Nixxye/projeto-oficinas1/README.md

# Guitar Healer

## Descrição
Uma das principais dificuldades em um processo de reabilitação motora é a perda de interesse dos pacientes. Os exercícios repetitivos e monótonos que fazem parte desse processo podem ser muito desestimulantes. Este projeto apresenta uma abordagem para superar esse obstáculo: um dispositivo projetado para estimular pacientes que necessitam de reabilitação motora nos dedos.

A ideia principal é transformar o processo de reabilitação em uma espécie de jogo de ritmo inspirado em Guitar Hero, onde o paciente realiza os exercícios necessários para jogar. O dispositivo tem como objetivo tornar o processo de reabilitação mais divertido e interessante, evitando a perda de interesse por parte dos pacientes e, consequentemente, aumentando a eficiência do processo de reabilitação.

## Objetivos
Tornar o processo de reabilitação motora mais envolvente e menos monótono.

Aumentar a motivação dos pacientes durante a reabilitação.

Melhorar a eficiência dos exercícios de reabilitação através da gamificação.

## Funcionalidades
Dispositivo de reabilitação motora com sensores para detectar movimentos dos dedos.

Jogo de ritmo inspirado em Guitar Hero para estimular os exercícios de reabilitação.

Feedback visual e sonoro para manter os pacientes engajados.

## Tecnologias Utilizadas
Linguagens de Programação C/C++ e Python
