Nixxye/projeto-oficinas1/Arduino/README.md

# Arduino

Códigos responsáveis pelo controle do jogo.
