Nixxye/projeto-oficinas1/(list of files, drawings)

Other design files:
Python/py-nrf24-master/doc/nano-nrf24-1.fzz
Python/py-nrf24-master/doc/pizw-nrf24-1-irq.fzz
Python/py-nrf24-master/doc/pizw-nrf24-1.fzz
Python/py-nrf24-master/doc/pizw-nrf24-2.fzz
