Nixxye/projeto-oficinas1/Rasp/lcd.cpp

/*
*
* by Lewis Loflin www.bristolwatch.com lewis@bvu.net
* http://www.bristolwatch.com/rpi/i2clcd.htm
* Using wiringPi by Gordon Henderson
*
*
* Port over lcd_i2c.py to C and added improvements.
* Supports 16x2 and 20x4 screens.
* This was to learn now the I2C lcd displays operate.
* There is no warrenty of any kind use at your own risk.
*
*/
//SDA -> GPIO2
//SLC -> GPIO3
#include <wiringPiI2C.h>
#include <wiringPi.h>
#include <stdlib.h>
#include <stdio.h>
#include <string.h>
// Define some device parameters
#define I2C_ADDR   0x27 // I2C device address

// Define some device constants
#define LCD_CHR  1 // Mode - Sending data
#define LCD_CMD  0 // Mode - Sending command

#define LINE1  0x80 // 1st line
#define LINE2  0xC0 // 2nd line

#define LCD_BACKLIGHT   0x08  // On
// LCD_BACKLIGHT = 0x00  # Off

#define ENABLE  0b00000100 // Enable bit

void lcd_init(void);
void lcd_byte(int bits, int mode);
void lcd_toggle_enable(int bits);

// added by Lewis
void typeInt(int i);
void typeFloat(float myFloat);
void lcdLoc(int line); //move cursor
void ClrLcd(void); // clr LCD return home
void typeln(const char *s);
void typeChar(char val);
int fd;  // seen by all subroutines

void ClrScnd();
void moveText(char *txt, int tam, char *s);
int main()   {

  if (wiringPiSetup () == -1) exit (1);

  fd = wiringPiI2CSetup(I2C_ADDR);

  //printf("fd = %d ", fd);

  lcd_init(); // setup LCD

  char music[] = "Passei quase duas horas no terceiro boss de lies of p D: ";
  char s[] = "                ";
  int size = strlen(music) - 1;
  while (1)   {

    lcdLoc(LINE1);
    typeln("Guitar Healer");
    lcdLoc(LINE2);
    typeln(s);
    moveText(music, size, s);
    delay(200);
    //ClrLcd();
    ClrScnd();
  }

  return 0;

}

void moveText(char *txt, int tam)
{
  char aux = txt[0];
  for (int i = 0; i < tam; i++)
  {
    txt[i] = txt[i+1];
  }
  txt[tam] = aux;
}

// float to string
void typeFloat(float myFloat)   {
  char buffer[20];
  sprintf(buffer, "%4.2f",  myFloat);
  typeln(buffer);
}

// int to string
void typeInt(int i)   {
  char array1[20];
  sprintf(array1, "%d",  i);
  typeln(array1);
}

// clr lcd go home loc 0x80
void ClrLcd(void)   {
  lcd_byte(0x01, LCD_CMD);
  lcd_byte(0x02, LCD_CMD);
}
void ClrScnd(void)   {
  lcdLoc(LINE2);
  typeln("                    ");
  lcdLoc(LINE2);

}
// go to location on LCD
void lcdLoc(int line)   {
  lcd_byte(line, LCD_CMD);
}

// out char to LCD at current position
void typeChar(char val)   {

  lcd_byte(val, LCD_CHR);
}


// this allows use of any size string
void typeln(const char *s)   {

  for (int i = 0; *s && i < 16; i++) lcd_byte(*(s++), LCD_CHR);

}

void lcd_byte(int bits, int mode)   {

  //Send byte to data pins
  // bits = the data
  // mode = 1 for data, 0 for command
  int bits_high;
  int bits_low;
  // uses the two half byte writes to LCD
  bits_high = mode | (bits & 0xF0) | LCD_BACKLIGHT ;
  bits_low = mode | ((bits << 4) & 0xF0) | LCD_BACKLIGHT ;

  // High bits
  wiringPiI2CReadReg8(fd, bits_high);
  lcd_toggle_enable(bits_high);

  // Low bits
  wiringPiI2CReadReg8(fd, bits_low);
  lcd_toggle_enable(bits_low);
}

void lcd_toggle_enable(int bits)   {
  // Toggle enable pin on LCD display
  delayMicroseconds(500);
  wiringPiI2CReadReg8(fd, (bits | ENABLE));
  delayMicroseconds(500);
  wiringPiI2CReadReg8(fd, (bits & ~ENABLE));
  delayMicroseconds(500);
}


void lcd_init()   {
  // Initialise display
  lcd_byte(0x33, LCD_CMD); // Initialise
  lcd_byte(0x32, LCD_CMD); // Initialise
  lcd_byte(0x06, LCD_CMD); // Cursor move direction
  lcd_byte(0x0C, LCD_CMD); // 0x0F On, Blink Off
  lcd_byte(0x28, LCD_CMD); // Data length, number of lines, font size
  lcd_byte(0x01, LCD_CMD); // Clear display
  delayMicroseconds(500);
}
