Nixxye/projeto-oficinas1/Rasp/motor_micro.py

from time import sleep
import pigpio

DIR = 21     # Direction GPIO Pin
STEP = 20    # Step GPIO Pin

# Connect to pigpiod daemon
pi = pigpio.pi()

# Set up pins as an output
pi.set_mode(DIR, pigpio.OUTPUT)
pi.set_mode(STEP, pigpio.OUTPUT)

MODE = (14, 15, 18)   # Microstep Resolution GPIO Pins
RESOLUTION = {'Full': (0, 0, 0),
              'Half': (1, 0, 0),
              '1/4': (0, 1, 0),
              '1/8': (1, 1, 0),
              '1/16': (0, 0, 1),
              '1/32': (1, 0, 1)}
for i in range(3):
    pi.write(MODE[i], RESOLUTION['Full'][i])

# Set duty cycle and frequency
pi.set_PWM_dutycycle(STEP, 128)  # PWM 1/2 On 1/2 Off
pi.set_PWM_frequency(STEP, 350)  # 500 pulses per second

try:
    while True:
        pi.write(DIR, 0)  # Set direction
        sleep(.1)

except KeyboardInterrupt:
    print ("\nCtrl-C pressed.  Stopping PIGPIO and exiting...")
finally:
    pi.set_PWM_dutycycle(STEP, 0)  # PWM off
    pi.stop()
