Nixxye/projeto-oficinas1/Simulacao/src/Receptor.cpp

#include "../Receptor/Receptor.h"
#include <thread>

using namespace std;

Receptor::Receptor():
inputs()
{
    RF24 radio(PIN_CE, PIN_CSN);

    radio.begin();

    radio.setChannel(115);

    radio.setPALevel(RF24_PA_HIGH);

    radio.setDataRate(RF24_1MBPS);

    radio.enableDynamicPayloads();

    radio.openReadingPipe(0, 0x7878787878LL);

    radio.printDetails();
}
Receptor::~Receptor()
{

}
std::queue<char>* Receptor::getFila()
{
    return &inputs;
}
void Receptor::captarInputs()
{
    radio.startListening(); 

    cout << "Start listening..." << endl;

    int receivedData;

    while (!terminar) 
    {

        if (radio.available(&pipeNumber)) 
        {        
            payloadSize = radio.getDynamicPayloadSize();

            int payload[payloadSize];

            receivedData = 0;

            radio.read(&payload, sizeof(payload));

            for (uint8_t i = 0; i < payloadSize; i++) 
            {
                receivedData += payload[i];
            }

            cout << "Pipe : " << (int) pipeNumber << " ";

            cout << "Size : " << (int) payloadSize << " ";

            cout << "Data : " << receivedData << endl;
            
            inputs.pushBack(receivedData);

            std::this_thread::sleep_for(std::chrono::milliseconds(100));     

        }

    }
        
}
