Nixxye/projeto-oficinas1/Simulacao/T_class.h

#pragma once
// Classe base para as classe que terão threads concorrentes

class T_class
{
protected:
    static bool terminar;
public:
    T_class()
    {

    }
    ~T_class()
    {
        terminar = true;
    }
};
