Nixxye/projeto-oficinas1/(commit log)

2023-09-08 Implementando threads
2023-09-08 Threads "funcionando"
2023-10-29 Motor em uma thread
2023-11-21 Leds em threads
2023-11-23 Musica em uma thread
2023-11-25 led + motor
2023-11-25 calibrate ok
